takoyakeeb/takoyaki8/hardware/README.md

# hardware/ — takoyaki8 の設計データ

takoyaki8 の基板とケースの設計データです。

Copyright (c) 2026 takoyakeeb
SPDX-License-Identifier: CERN-OHL-P-2.0

## ライセンス

- この `hardware/` の中のファイル(ケースの図面を作るスクリプトを含む)は、下の「他人のファイル」を除いて、CERN-OHL-P-2.0(CERN Open Hardware Licence Version 2 - Permissive)です。全文は、リポジトリのルートの `LICENSE-HARDWARE` を見てください。
- ルートの `LICENSE`(MIT)は、ファームウェアと文書のライセンスです。

## 中身

| 場所 | 内容 |
|---|---|
| `takoyaki8.kicad_pro`、`takoyaki8.kicad_sch`、`takoyaki8.kicad_pcb` | KiCad のプロジェクト、回路図、基板。KiCad 10.0 で作成(古い版では、開けないことがあります) |
| `fp-lib-table`、`sym-lib-table` | ライブラリの表。自作ライブラリ(`lib/`)を指します |
| `lib/` | 自作のシンボル(RP2040-Zero)とフットプリント。出典と寸法は、`lib/README.md` |
| `case/` | ケース(アクリル)の寸法メモ(`README.md`)、入稿用の図面(SVG)を作るスクリプト(`acrylic_svg.py`)とその検算(`check_acrylic_svg.py`)、配置データ(`layout_30x30_v2.json`)、ロゴなどの素材(`art/`)。スクリプトは、複数セット分を並べた図面を作ります(1セット分の図面は、まだ出せません) |
| `case-3d/` | 3D プリントのケース(バンパー)。FreeCAD の元データ(`bumper.FCStd`)、`bumper.step`、`bumper.stl`。説明は、下の「バンパー」 |
| `gerber/` | KiCad から書き出した Gerber の置き場所(書き出しの設定は、プロジェクトに保存済み)。リポジトリには含めません(`.gitignore`)。配布は、GitHub のリリース `hw-rev1.0` |

## 基板

- 2層、板厚 1.6mm。メイン基板とトッププレートを、1枚のパネルにしています。マウスバイトで切り離します。
- KiCad の DRC に、マウスバイトの穴の警告が24件出ます(意図した設計です)。
- 発注に使った版には、タグ `hw-rev1.0-order1` が付いています。

## バンパー(3D プリント)

アクリルのサンドイッチ(ボトムプレート、基板、トッププレート)の外側を囲む枠です。上から落とし込みます。ネジは使いません。

- 基板とアクリルは、斜めに挿し込んで入れます。下から指で押し上げて、外します。
- 底は塞がないので、BOOT/RESET の穴は、そのまま使えます。
- 壁の内側の小さな出っ張り(リブ)が、基板の側面を押さえるので、ひっくり返しても、中身は抜け落ちません。

### 寸法

単位は mm です。原点は、バンパーの中心です。上から見て、基板の上辺(USB 側)が +Y、基板の左端が -X です。高さ z は、バンパーの底の下面を 0 とします。

| 項目 | 値 |
|---|---|
| 外形 | 106.7 × 47.25(壁の厚み 3.0)。高さは、カバー側(x < -24.0)が 17.2、キー側(x > -24.0)が 12.7 |
| 内側の穴 | 100.7 × 41.25(基板 99.9 × 40.05 に対して、X は片側 0.4、Y は片側 0.6 のすき間) |
| 底の縁 | 厚み 1.0、内側へ 1.7(開口 97.3 × 37.85) |
| 角の丸め | 外側 R3.4、内側 R1.4。壁の高さの段差(x = -24.0)の角は、R1.5 |
| USB の開口 | +Y の壁に、幅 13.0(X -42.95 〜 -29.95)、底 2.2、天井 9.7(高さ 7.5)。上は壁でふさぐ。4つの角は、すべて R1.5。端子(基板の厚みを含めて、高さ 約4.5)の上下に、約 1.5 ずつ空く |
| USB の座ぐり | USB の開口のまわりを、外側から深さ 1.0 だけ浅く掘る(X -44.45 〜 -28.45、z 1.2 〜 10.7、角 R2.0)。ケーブルの根元が、深く入るようにするため |
| 押さえのリブ | +Y と -Y の壁に、向かい合わせで 4 組(8 個)。x = -46、-20、12、44。丸い出っ張りで、基板とトッププレートの側面に当たる |

リブの寸法(8 個とも、先の間隔は同じ):

- リブ先どうしの間隔 39.55(壁の内側からの突き出し 0.85。先端は Y = ±19.775)。基板の短辺(40.05。実測は 40.00〜40.02)に対して、設計の食い込みは、片側 0.23〜0.25
- 高さ z = 3.8 〜 10.2(底のアクリル(短辺 39.85。z = 1.0 〜 3.1)に当たらないよう、アクリルの上から始める)
- 幅は、x = -46(カバー側の端)が 4、ほかが 約 5
- 印刷すると、リブは、設計より片側 約0.08〜0.11 低く出る(実測のリブ先の間隔は 39.70〜39.76)。実際の食い込みは、片側 約0.12〜0.16

高さ: 底の縁の上面(z = 1.0)が、ボトムプレートの下面です。キー側の壁の上端(12.7)と、キーキャップの下端のすき間は、17mm のキーキャップで 1.5〜1.7、19mm のキーキャップで 約 0.2 です。

### 印刷の条件

- プリンター: Bambu Lab A1 mini(ノズル 0.4)、スライサー: Bambu Studio
- 材料: PLA(つや消しの白)
- 設定: 積層ピッチ 0.20、壁 4周(壁が 3.0 なので、壁の全体が外周の線で埋まるようにする)、サポートなし
- 向き: 底の縁を下にして、`bumper.stl` のまま置く。印刷時間は、約31分

### 印刷の注意

- 外形は、設計より約0.5%小さく出ます。すき間は、この縮みを見込んでいます。別のプリンターや材料では、縮み方が変わります。リブも、縮みの影響で、設計より低く出ます。
- 入れるときが固すぎるときは、リブの先を、細かい紙やすりで少し削ってください。ゆるいときは、リブ先の間隔を 0.1 ずつ小さくして、作り直してください(片側の食い込みが 0.05 ずつ増えます)。
- 温かいうちに剥がすと、底が反ります(0.4mm くらい)。プレートが完全に冷めてから、剥がしてください。

## 他人のファイル

- **Choc v2 のホットスワップソケットのフットプリント**(`lib/takoyaki8.pretty/SW_choc_v2_HS_CPG135001S30_1u.kicad_mod`): marbastlib の `marbastlib-xp-choc`(ebastler/marbastlib、CERN-OHL-P-2.0)から、2026-10-05 にコピーしました。寸法は、Kailh の資料と、実物で確認しています(`lib/README.md`)。3D モデル(STEP)は、パスで参照しているだけで、このリポジトリには含めていません。
- **KiCad 標準ライブラリの部品**(Capacitor_SMD、Diode_SMD、LED_SMD、Resistor_SMD): 回路図と基板に、部品として含まれています。KiCad のライブラリは CC-BY-SA 4.0 ですが、例外があり、ライブラリを設計に使うだけなら、設計データを CC-BY-SA にする必要はありません(<https://www.kicad.org/libraries/license/>)。ライブラリのファイルそのものは、このリポジトリに含めていません。
- RP2040-Zero のシンボルとフットプリントは、自作です。ピン配置は、Waveshare 公式の図を見て作りました(図そのものは含めていません)。
- ロゴ(`lib/takoyaki8.pretty/TakoyaKeeb_logo.kicad_mod`、`case/art/`)は、自作です。
- バンパー(`case-3d/`)は、自作です。他人のファイルは使っていません。
