takoyakeeb/takoyaki8/hardware/case-3d/bumper.step

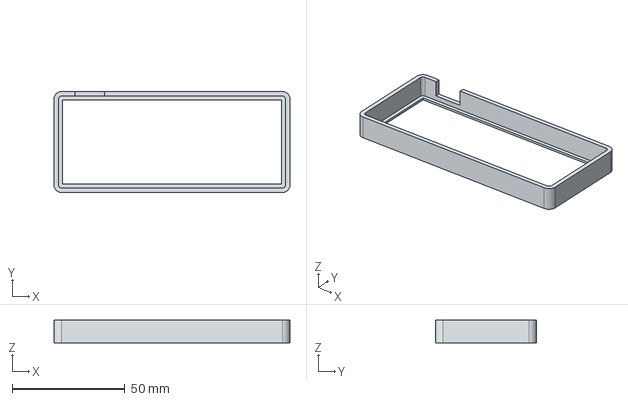
[picture p3: CAD file, 2026-10-22]
hardware/case-3d/bumper.step
104.7 x 44.9 x 10.2 mm
