takoyakeeb/takoyaki8/(list of files, cad)

Other CAD files:
hardware/case-3d/bumper.FCStd
hardware/case-3d/bumper.stl
