takoyakeeb/takoyaki8/hardware/case/drawings/takoyaki8_acrylic_set1.pdf

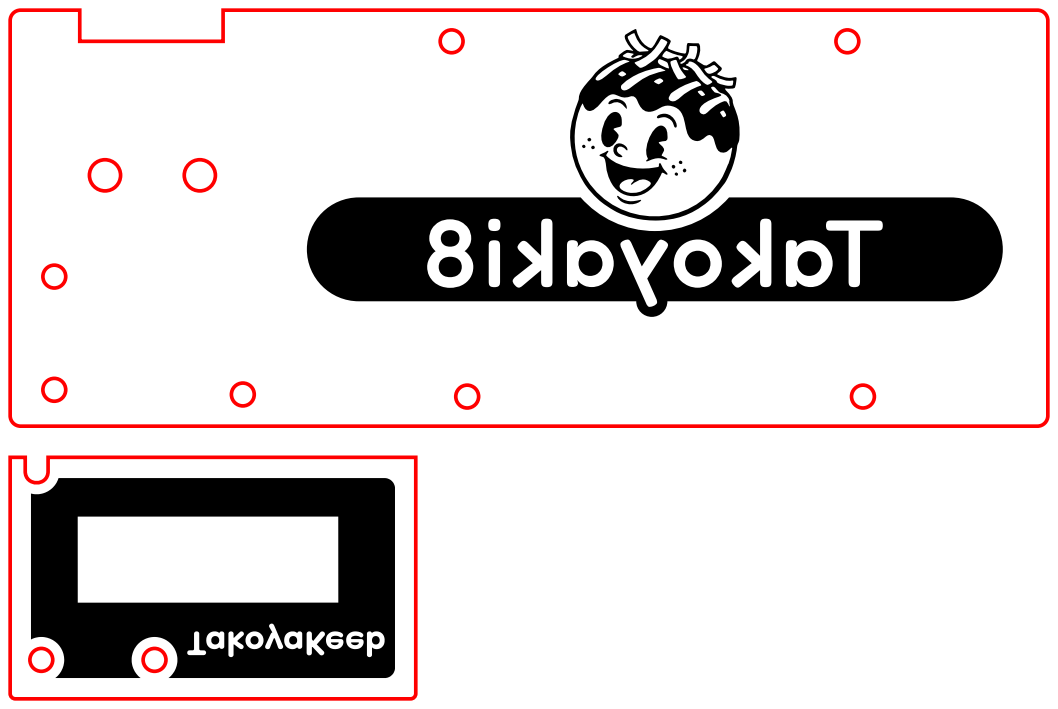
[picture p4: page 1]
