takoyakeeb/takoyaki8/hardware/takoyaki8.kicad_pcb

## KiCad design hardware/takoyaki8.kicad_pcb (2026-10-19)

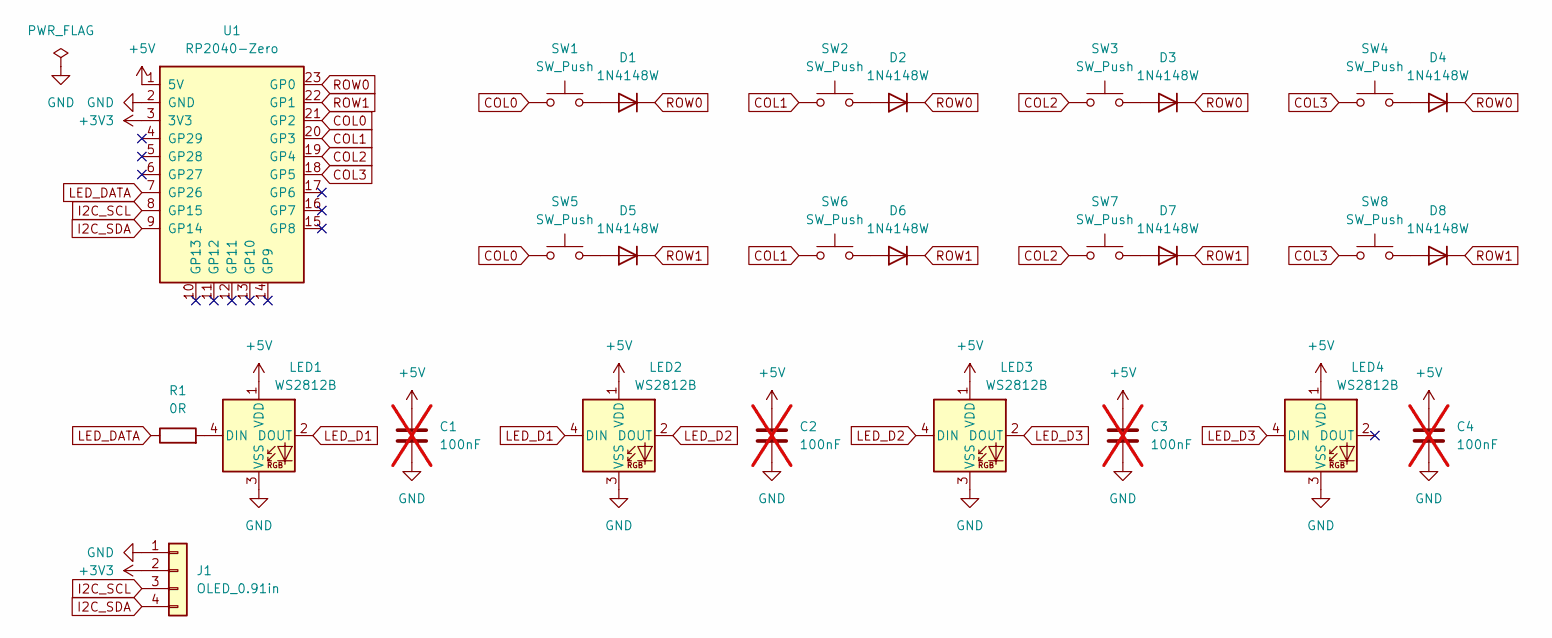
[picture p5: schematic takoyaki8.kicad_sch]

Parts:
C1, C2, C3, C4: 100nF; C_0603_1608Metric; not fitted
D1, D2, D3, D4, D5, D6, D7, D8: 1N4148W; D_SOD-123
J1: OLED_0.91in; OLED_0.91in_I2C_Header
LED1, LED2, LED3, LED4: WS2812B; LED_WS2812B_PLCC4_5.0x5.0mm_P3.2mm
R1: 0R; R_0603_1608Metric
SW1, SW2, SW3, SW4, SW5, SW6, SW7, SW8: SW_Push; SW_choc_v2_HS_CPG135001S30_1u
U1: RP2040-Zero; RP2040-Zero_Castellated_Flipped

Connections:
+3V3: J1.2, U1.3 (3V3)
+5V: C1.1, C2.1, C3.1, C4.1, LED1.1 (VDD), LED2.1 (VDD), LED3.1 (VDD), LED4.1 (VDD), U1.1 (5V)
COL0: SW1.1, SW5.1, U1.21 (GP2)
COL1: SW2.1, SW6.1, U1.20 (GP3)
COL2: SW3.1, SW7.1, U1.19 (GP4)
COL3: SW4.1, SW8.1, U1.18 (GP5)
GND: C1.2, C2.2, C3.2, C4.2, J1.1, LED1.3 (VSS), LED2.3 (VSS), LED3.3 (VSS), LED4.3 (VSS), U1.2 (GND)
I2C_SCL: J1.3, U1.8 (GP15)
I2C_SDA: J1.4, U1.9 (GP14)
LED_D1: LED1.2 (DOUT), LED2.4 (DIN)
LED_D2: LED2.2 (DOUT), LED3.4 (DIN)
LED_D3: LED3.2 (DOUT), LED4.4 (DIN)
LED_DATA: R1.1, U1.7 (GP26)
unnamed: D1.2 (A), SW1.2
unnamed: D2.2 (A), SW2.2
unnamed: D3.2 (A), SW3.2
unnamed: D4.2 (A), SW4.2
unnamed: D5.2 (A), SW5.2
unnamed: D6.2 (A), SW6.2
unnamed: D7.2 (A), SW7.2
unnamed: D8.2 (A), SW8.2
unnamed: LED1.4 (DIN), R1.2
ROW0: D1.1 (K), D2.1 (K), D3.1 (K), D4.1 (K), U1.23 (GP0)
ROW1: D5.1 (K), D6.1 (K), D7.1 (K), D8.1 (K), U1.22 (GP1)

Board: 2 copper layers, 33 parts (25 on the bottom side), 24 nets, no tracks yet.

Other parts of the board:
MB1, MB2, MB3, MB4, MB5, MB6: MouseBite; MouseBite_5x0.5mm_P0.85mm
