takoyakeeb/takoyaki8/(commit log)

2026-09-28 Add wiring documentation
2026-09-28 Link wiring docs from README
2026-10-02 Add WS2812B LED driver for breadboard check (wip)
2026-10-03 OLED: start after boot delay, retry I2C setup, stop after repeated failures (wip)
2026-10-03 Update wiring.md: LED and OLED confirmed on breadboard
2026-10-03 Bump firmware version to 0.4.0 (LED and OLED)
2026-10-04 Add KiCad project skeleton (hardware/)
    [takoyaki8.kicad_pcb, takoyaki8.kicad_sch]
2026-10-04 Set KiCad board setup (mm, 0.05mm grid, 2 layers)
    [takoyaki8.kicad_pcb]
2026-10-05 Add project footprint library (Choc v2 hotswap from marbastlib-xp-choc)
2026-10-05 Add key matrix and LED chain to schematic (wip)
    [takoyaki8.kicad_sch]
2026-10-05 Add RP2040-Zero symbol and castellated footprint (provisional pads)
    [takoyaki8.kicad_sch]
2026-10-05 Complete minimal schematic: matrix, LED chain, RP2040-Zero, OLED connector (ERC clean)
    [takoyaki8.kicad_sch]
2026-10-05 Add OLED header and flipped RP2040-Zero footprints (sandwich plan, provisional)
    [takoyaki8.kicad_sch]
2026-10-05 Update flipped RP2040-Zero footprint: component zones from 1:1 print, larger window
    [takoyaki8.kicad_sch]
2026-10-05 Place parts on first-draft layout: outline with RP2040-Zero notch, mounting holes, OLED silk outline removed (DRC clean except silk text)
    [takoyaki8.kicad_pcb]
2026-10-05 Add top plate, panel tabs and mouse-bite holes (DRC clean except silk text)
    [takoyaki8.kicad_pcb]
2026-10-06 Add GND zones on both layers, Power netclass, hole-to-hole 0.5mm (DRC: 0 errors, 40 unconnected, 24 mouse-bite hole warnings)
    [takoyaki8.kicad_pcb]
2026-10-06 Route +5V: U1 to LEDs and bypass caps (DRC: 0 errors, 32 unconnected)
    [takoyaki8.kicad_pcb]
2026-10-06 Route LED data chain (GPIO26 -> R1 -> LED1..4) and chamfer +5V corners (DRC: 0 errors, 27 unconnected)
    [takoyaki8.kicad_pcb]
2026-10-07 Route matrix, I2C and +3V3 by hand, add GND stitching vias (DRC: 0 errors, 0 unconnected, 48 warnings: mouse-bite holes and silk)
    [takoyaki8.kicad_pcb]
2026-10-07 Tidy silkscreen reference text (DRC: 0 errors, 0 unconnected, 24 mouse-bite hole warnings)
    [takoyaki8.kicad_pcb]
2026-10-07 Add silkscreen: logo, copyright, board name/rev, GitHub URL (DRC: 0 errors, 0 unconnected, 24 mouse-bite hole warnings)
    [takoyaki8.kicad_pcb]
2026-10-08 Save Gerber plot settings (output dir, plot layers)
    [takoyaki8.kicad_pcb]
2026-10-08 Add polarity markers on B.Silkscreen for diodes and LEDs (DRC: 0 errors, 0 unconnected, 24 mouse-bite hole warnings)
    [takoyaki8.kicad_pcb]
2026-10-08 Update lib README: add logo footprint, record real-part checks (fit, plate hole 14.0, board 1.6mm), mouse-bite notes
2026-10-09 Add case design memo (step 16): z-stack, holes, spacers and screws, checks after PCB arrival
2026-10-14 Set NumLEDs to 4 and default keymap (MacOS / Meet) for board rev1.0
2026-10-14 Bump firmware version to 0.4.1 (board rev1.0 config)
2026-10-14 Slow LED chase to 100 loops so 4 LEDs are easy to follow
2026-10-14 Update wiring.md: board rev1.0 config and fw 0.4.1 checks
2026-10-17 Add README draft: overview, parts, assembly, firmware, tinykeemap
2026-10-17 Update README for board rev1.0 config: LED 4, default keymap, OLED orientation, wiring.md
2026-10-19 Add hardware/README.md, record case check results, ignore gerber/
2026-10-19 Update README (status, parts, hardware data, case assembly, files, license) and wiring.md after importing hardware
2026-10-19 Update README: remove status section, point to release for .uf2/Gerber/BOM, add notes
2026-10-20 Add bumper v0 (FreeCAD, STEP, STL) to hardware/case-3d
2026-10-22 hardware/README: add bumper section (dimensions, print conditions, results)
2026-10-23 hardware/README: gerber is distributed in release hw-rev1.0
2026-10-26 fw 0.4.2: show current layer on OLED, swap L0 keys 3/7, generic L1
2026-10-26 docs/wiring: update OLED orientation and fw 0.4.2 check results
2026-10-29 case: add bumper v2d (wall 3.0, rib gap 39.55, USB window 7.5mm)
2026-10-29 case: bumper v2d replaces v2c (wall 3.0, rib gap 39.55, USB window 7.5mm)
2026-11-04 docs: add exploded view and photos, unify screws to M2x4, spacer 5mm
2026-11-04 case: export one set of acrylic drawings (SVG/PDF/DXF)
2026-11-04 fw: LED layer/off/test effects with per-layer color and brightness from cfg
2026-11-04 fw: LED press effect (flash on key press, fade out)
2026-11-04 fw: LED breathe effect; share fast update interval (ledFastLoops)
2026-11-04 fw: raise ledMaxLevel to 255; fix LED interval comments
2026-11-04 fw: default led 80%; update wiring.md for ledMaxLevel and update intervals
2026-11-04 fw: CFG LIST returns candidates as name=a|b|c (led_mode)
2026-11-13 docs: point pin and keymap references to model_takoyaki8.go
